deividAlfa/Alfa166Bluetooth/Pictures/411_BLACK_PILL.png

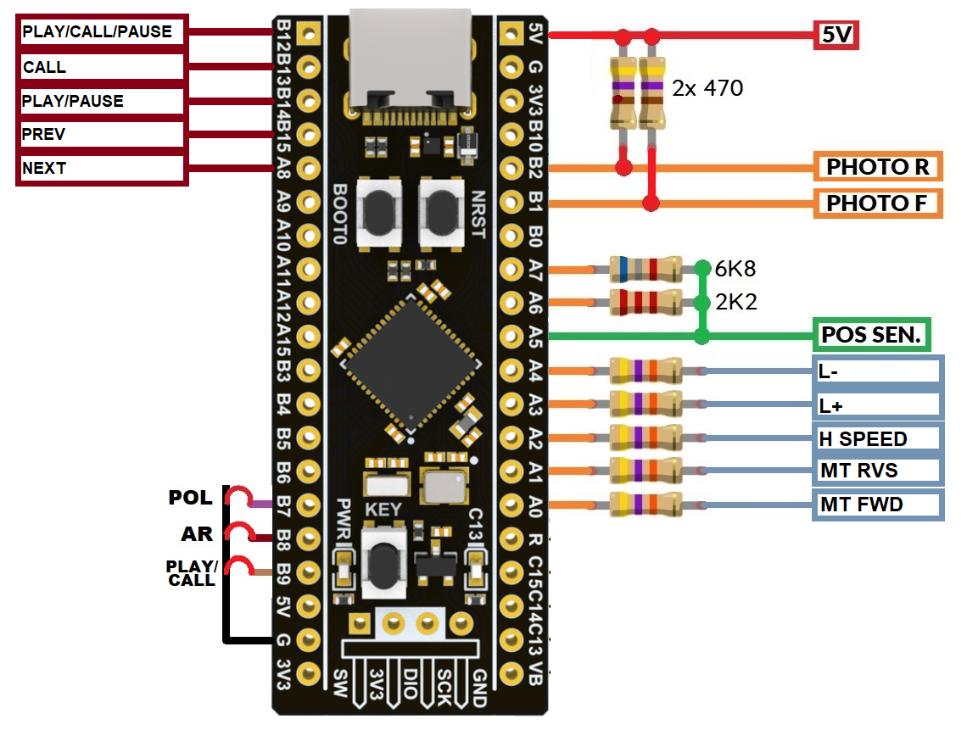
Pictures/411_BLACK_PILL.png
