deividAlfa/Alfa166Bluetooth/Core/Inc/main.h

#define LED_Pin GPIO_PIN_13
#define LED_GPIO_Port GPIOC
#define POLARITY_Pin GPIO_PIN_0
#define POLARITY_GPIO_Port GPIOA
#define RESUME_Pin GPIO_PIN_1
#define RESUME_GPIO_Port GPIOA
#define CALL_PAUSE_Pin GPIO_PIN_2
#define CALL_PAUSE_GPIO_Port GPIOA
#define BTN_PLAY_PAUSE_CALL_Pin GPIO_PIN_7
#define BTN_PLAY_PAUSE_CALL_GPIO_Port GPIOA
#define BTN_CALL_Pin GPIO_PIN_0
#define BTN_CALL_GPIO_Port GPIOB
#define BTN_PLAY_PAUSE_Pin GPIO_PIN_1
#define BTN_PLAY_PAUSE_GPIO_Port GPIOB
#define BTN_PREV_Pin GPIO_PIN_10
#define BTN_PREV_GPIO_Port GPIOB
#define BTN_NEXT_Pin GPIO_PIN_11
#define BTN_NEXT_GPIO_Port GPIOB
#define POS_0_Pin GPIO_PIN_12
#define POS_0_GPIO_Port GPIOB
#define POS_1_2_Pin GPIO_PIN_13
#define POS_1_2_GPIO_Port GPIOB
#define POS_2_5_Pin GPIO_PIN_14
#define POS_2_5_GPIO_Port GPIOB
#define L_minus_Pin GPIO_PIN_15
#define L_minus_GPIO_Port GPIOB
#define L_plus_Pin GPIO_PIN_8
#define L_plus_GPIO_Port GPIOA
#define MT_RVS_Pin GPIO_PIN_9
#define MT_RVS_GPIO_Port GPIOA
#define H_SPEED_Pin GPIO_PIN_10
#define H_SPEED_GPIO_Port GPIOA
#define MT_FWD_Pin GPIO_PIN_11
#define MT_FWD_GPIO_Port GPIOA
#define PHOTO_F_Pin GPIO_PIN_6
#define PHOTO_F_GPIO_Port GPIOB
#define PHOTO_R_Pin GPIO_PIN_7
#define PHOTO_R_GPIO_Port GPIOB
