deividAlfa/Alfa166Bluetooth/Core/Inc/tape.h

/*
 * tape.h
 *
 *  Created on: Jan 12, 2021 Dec 22, 2020
 *      Author: David
 */

#ifndef INC_TAPE_H_
#define INC_TAPE_H_
#include "main.h"


 /***********************************************************************************************************************************************************************************************************************************************************
 *     TO CHANGE THE GPIO PINS, FOLLOW THIS TABLE (GPIO USER NAME IS SET IN CUBEMX):
 *
 *     GPIO NAME            MODE      OPTIONS           DESCRIPTION.
 * ***********************************************      Input signals.
 *     MT_FWD               INPUT     NO PULL           Signal from board, spin motor in forward direction.
 *     MTD_RVS              INPUT     NO PULL           Signal from board, spin motor in reverse direction.
 *     H_SPEED              INPUT     NO PULL           Signal from board, spin motor in high speed.
 *     L_plus               INPUT     NO PULL           Signal from board, lift or lower the reading head.
 *     L_minus              INPUT     NO PULL           Same, opposite direction.
 *
 * ***********************************************      Config inputs.
 *     POLARITY             INPUT     PULLUP            Output buttons polarity:
 *                                                          Open:   Button idle state 0V (Low Level).
 *                                                          Closed: Button idle state VCC (High level).
 *     RESUME               INPUT     PULLUP            Auto Resume mode:
 *                                                          Open:   In pause state, cellphone resumes playback automatically after skipping tracks.
 *                                                          Closed: In pause state, cellphone doesn't resume playback automatically after skipping tracks.
 *     CALL_PAUSE           INPUT     PULLUP            Play / Call. Selects the working mode of the ICS "1-2" button:
 *                                                         Open:   Play / Pause.
 *                                                         Closed: Answer Call.
 *     NO_REPEAT            INPUT     PULLUP            If pushing the same button quickly causes issues with your phone, disable skip repeat functionality.
 *                                                         Open:   Repeat is enabled (Multiple track skips when pressing the button fast).
 *                                                         Closed: Repeat is disabled.
 *
 * ***********************************************      POS_SEN output: In the original tape mechanism, it's the output voltage from a potentiometer indicating the head position.
 *                                                      The controller activates L+ (L_plus) or L- (L_minus) until it gets the voltage it wants.
 *                                                      We simulate it with a crude DAC, only 3 steps are enough to trick the board. There's a 6K8 pullup to 5V in the ICS board.
 *     POS_0V               OUTPUT    OPEN DRAIN        POS SEN pulled to ground.                          0V   = Tape inserted, head lowered (Playing).
 *     POS_1_2V             OUTPUT    OPEN DRAIN        POS SEN pulled to ground through a 2K2 resistor.   1.2V = Tape inserted, head half-lowered (Moving).
 *     POS_2_5V             OUTPUT    OPEN DRAIN        POS SEN pulled to ground through a 6K8 resistor.   2.5V = Tape inserted, head lifted (Stopped).
 *                                                      All outputs disabled give 5V.                      5V   = No tape (Unused).
 *
 * ***********************************************      Photodetector outputs.
 *     PHOTO_R              OUTPUT    OPEN DRAIN        Pulses from one of the tape wheels, indicating it's moving.
 *     PHOTO_F              OUTPUT    OPEN DRAIN        Pulses from ome of the tape wheels, indicating it's moving.
 *                                                      When any stops, the radio detects the end of the tape and reverses the play direction. We use it as temporal pause when skipping tracks.
 *
 * ***********************************************      Button outputs for BT module.
 *     BTN_PREV             OUTPUT    OPEN DRAIN        Previous track.
 *     BTN_NEXT             OUTPUT    OPEN DRAIN        Next track.
 *     BTN_CALL             OUTPUT    OPEN DRAIN        Answer Call.
 *     BTN_PLAY_PAUSE       OUTPUT    OPEN DRAIN        Play Pause.
 *     BTN_PLAY_PAUSE_CALL  OUTPUT    OPEN DRAIN        Play Pause Answer Call (Combines Play/Pause and Answer Call).
 *
 *    Be careful! If the outputs are not set as open drain, the pin will output 3.3V when high.
 *    This might damage the bluetooth module if it works at a lower voltage, ex. 1.8V.
 *    Also, the photo sensors won't recognize a 3.3V signal, they need 5V pulses to work!
 *
 ***********************************************************************************************************************************************************************************************************************************************************/

typedef enum{
  reset_val=0,

  pos_0V,                                       // Play position. Signal direct to GND, 0V
  pos_1_2V,                                     // Transition from/to play position. 2.2K resistor to GND, 1.2V
  pos_2_5V,                                     // Tape in, also RWD and FF position. 6.8K resistor to GND, 2.5V
  pos_5V,                                       // No tape, all positions floating (Unused)

  status_stop,                                  // In stop mode
  status_play,                                  // Playing
  status_pause,                                 // Pause
  status_frwd,                                  // Fast rewind
  status_ffwd,                                  // Fast forward

  fwdPlay,                                      // Playing in forward mode
  revPlay,                                      // Playing in reverse mode

  btn_next,                                     // Next track button
  btn_prev,                                     // Previous track button
  btn_call,                                     // Call button
  btn_play_pause,                               // Play-Pause button
  btn_play_pause_Call,                          // Play-Pause-call button

}status_t;


// Struct for tape management
typedef struct{
  volatile uint32_t         delayPhotoTimer;    // Timer for photo sensor disable delay
  volatile uint32_t         playTimer;          // Time when the playback started
  volatile uint32_t         freqPhotoTimer;     // Timer for photo sensor signal generation
  volatile uint32_t         changedTimer;       // Timer for delay after skip tracks.
  volatile uint32_t         skipTimer;          // Timer To recognize if the tape returned to play mode by itself or if a button was pulsed again (add another pulse to the BT module)
  volatile uint32_t         stopTimer;          // Time to measure stop state

  volatile uint8_t          skipCnt;            // Counter for consecutive skips. More than 4 fast skips will make the tape think it's stuck. Wait longer this time.
  volatile status_t         playMode;           // Last known play mode
  volatile uint32_t         btnTimer;           // Timer used for buttons
  volatile status_t         skipBtn;            // Stored skip track button
  volatile status_t         status;             // Actual tape status
  volatile status_t         BTstatus;           // Actual BT status

  volatile bool             btnPushed;          // Flag to indicate a button was pushed (for reseting after timer expired timer)
  volatile bool             enablePhoto;        // Flag to enable or disable the photo sensor signal (For forcing RWD/FF modes to stop and resume and play mode)
  volatile bool             polarity;           // Flag to set the button polarity depending on the POL_TAPE input (Normally low, normally high)
  volatile bool             skipResume;         // Flag to indicate if the phone resumes playback after skipping a track (being n pause before)
  volatile bool             callOrPause;        // Flag to indicate the use of 1-2 button. As pause/resume or call output.
  volatile bool             noRepeat;           // Flag to indicate if repeat functionality is disabled
  volatile bool             repeatSkip;         // Flag to indicate there's a repeat pending
}tape_t;

// Struct for tape position function
typedef struct{
  volatile status_t         OutLevel;           // Actual analog position
  volatile uint32_t         Timer;              // Timer for position transition delays
  volatile uint8_t          Status;             // For position state machine
volatile int8_t             Direction;          // Switching direction
}position_t;

// Extensively tested, different times will probably cause malfunctioning
// Pretty critical timings! Delays in mS

#define positionDelay       100                 // Delay before changing positions, to let the controller process the signal and turn on/off the position motor. Less than 80mS will randomly fail
#define pulseDelay          10                  // High/low times for photo sensor signal generation (F = 50Hz)
#define longPhotoDelay      1300                // Photo sensor long delay time (to prevent fault detection if too many fast skips)
#define btnHighTime         100                 // Button active time (Most modules will ignore shorter times)
#define btnLowTime          400                 // Button idle time, to ensure enough time between button presses
#define btnRepTimHigh       1200                // Max time after returning to play state to recognize repeated button presses (The controller reverts automatically to play mode in 1.3 seconds)
#define btnRepTimLow        10                  // Min time to recognize repeated button presses
#define resetTimeOnPlay     2000                // Time in play state to reset the fast skip counter
#define resumeDelay         300                 // After returning to playback state, time to wait before sending play pulse. If too fast the phone might ignore it.
#define stopDelay           50                  // Min time in stop mode to actually set stop status
#define delay1_2            100                 // Min time in play mode to read 1-2 button (to avoid noises)

#define MIN_POS             pos_0V              // Minimum position
#define MAX_POS             pos_2_5V            // Maximum position
#define MAX_FAST_SKIP       4                   // Maximum fast skips before adding delay, to prevent fault detection

#define H_Speed             HAL_GPIO_ReadPin(H_SPEED_GPIO_Port, H_SPEED_Pin)
#define MT_Fwd              HAL_GPIO_ReadPin(MT_FWD_GPIO_Port, MT_FWD_Pin)
#define MT_Rev              HAL_GPIO_ReadPin(MT_RVS_GPIO_Port, MT_RVS_Pin)
#define L_Plus              HAL_GPIO_ReadPin(L_plus_GPIO_Port, L_plus_Pin)
#define L_Minus             HAL_GPIO_ReadPin(L_minus_GPIO_Port, L_minus_Pin)


#define setPos_2_5vHigh()   HAL_GPIO_WritePin(POS_2_5_GPIO_Port,POS_2_5_Pin,SET)
#define setPos_2_5vLow()    HAL_GPIO_WritePin(POS_2_5_GPIO_Port,POS_2_5_Pin,RESET)
#define setPos_1_2vHigh()   HAL_GPIO_WritePin(POS_1_2_GPIO_Port,POS_1_2_Pin,SET)
#define setPos_1_2vLow()    HAL_GPIO_WritePin(POS_1_2_GPIO_Port,POS_1_2_Pin,RESET)
#define setPos_0vHigh()     HAL_GPIO_WritePin(POS_0_GPIO_Port,POS_0_Pin,SET)
#define setPos_0vLow()      HAL_GPIO_WritePin(POS_0_GPIO_Port,POS_0_Pin,RESET)

#define EnableRepeat        1

void initTape(void);
void handleTape(void);
void handlePosSensor(void);
void handleLed(void);
void setButton(status_t btn);
void handleButtonReset(void);

#endif /* INC_TAPE_H_ */
