deividAlfa/Alfa166Bluetooth/(commit log)

2021-01-19 Fix button polarity not checked at startup
    [tape.c]
2021-01-21 Added additional Play/Pause output,to pause between track changes, as the tape system is too slow and the song would lose the first 2 seconds.
    [tape.c, tape.h, tape.ioc]
2021-03-08 Fixed wrong pinout (Older version) has been uploaded
    [main.h, tape.ioc]
2021-04-12 Fix polarity input, enabled pull down resistor
    [tape.ioc]
2021-04-12 Fixes.
    Solved timing issues with some phones.
    Added "auto resume" setting for better compatibility (See readme).
    Simplified code.
    [tape Release.cfg]
2021-04-14 test builds with buttons in higher time in low state
2021-04-14 Test build with no double skip (when returning fast because button was pushed twice quickly)
2021-04-14 Fixed repeat issues. Now it should work perfect.
    [tape.c, tape.h]
2021-04-14 Multiple builds
    Each btnOff means the time to wait before pushing a button again.
    Going too fast might fail on some phones, so I set 200, 400,600,800 and
    1000mS builds.
    If it only fails when quickly pressing the ICS buttons,and none of the
    other builds work, it means the phone or the module can't take two
    consecutive next/prev pulses, use noRepeat build.
2021-04-15 Update
    Support single button for play_pause_call.
    Automatic pause and resume when exiting and resuming tape mdoe in the
    ICS.
2021-04-15 Fix a bug done in the recent changes
    [tape.c, tape.h]
2021-04-15 Latest updates.
    Added 1-2 button working modes (call or play/pause)
    Adjusted timings and small fixes.
    [main.h, tape.c, tape.h, tape.ioc]
2021-07-21 Fixed another pause bug
    [tape.c]
2021-07-21 my different board layout (Same functionality)
2021-07-21 Use PA3 as "no repeat". Bridge to gnd to disable repeat.
